yassin964770/iv-monitor/report-figures/fig1-board.html

Load cell, 3 kgخلية الحمل، 3 كغم

Wooden arm holding the load cellذراع خشبي يحمل خلية الحمل

IV bottle, hung from the load cellقنينة المحلول، معلّقة بخلية الحمل

Drip chamberحجرة التنقيط

IV tubeأنبوب المحلول

To the patientإلى المريض

USB cable to the ESP32كيبل USB للـESP32

OLED screen, 0.96 inشاشة OLED بقياس 0.96 إنش

ESP32 microcontrollerالمتحكم ESP32

HX711 amplifierمضخّم الإشارة HX711

Breadboardلوحة التوصيل

Red and green lights, 220 Ω eachضوء أحمر وأخضر، مقاومة 220 أوم لكل واحد

Buzzerالجرس

Servo lead and power wires, tapedسلك السيرفو وسلك التغذية، مثبّتان بشريط

Pinch point: the horn presses the tubeنقطة الضغط: ذراع السيرفو يعصر الأنبوب

Servo motor, the valveمحرك سيرفو يعمل كصمام

Wooden block behind the tubeقطعة خشب خلف الأنبوب

Cut USB cable: 5 V and GND for the servoكيبل USB مقصوص: 5 فولت والأرضي للسيرفو

Power bank, or a USB charger with two portsباور بانك، أو شاحن USB بمنفذين
