yassin964770/iv-monitor/report-figures/fig3-lights-buzzer.html

ESP32 microcontrollerالمتحكم ESP32

Green: plenty leftأخضر: الكمية كافية

Red: nearly emptyأحمر: قرب ينتهي

Active buzzer, 2 legsجرس نشط بطرفين

Each LED: pin, then a 220 Ω resistor, then the long leg (+); the short leg (−) to ground.كل ليد: المنفذ، بعدين مقاومة 220 أوم، بعدين رجله الطويلة (+)، ورجله القصيرة (−) للأرضي.

Buzzer: long leg (+) to GPIO 25, short leg (−) to ground, no resistor (an active buzzer).الجرس: رجله الطويلة (+) على GPIO 25، والقصيرة (−) للأرضي، بدون مقاومة (جرس نشط).

All grounds are joined with the ESP32 ground.كل الأرضيات موصولة بأرضي ESP32.
