yassin964770/iv-monitor/print-parts/cam-valve-drawings.pdf

منظر من األعلى

منظر من األسفل، جهة السريفو

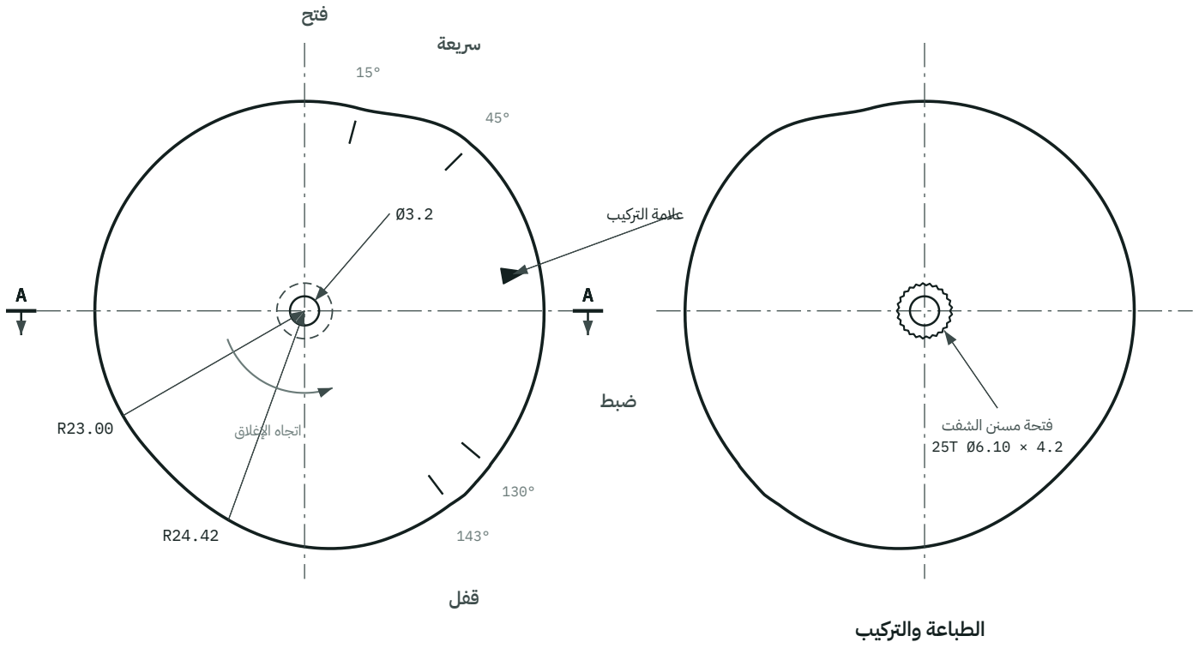
[picture p1: figure]
فتح; رسيعة; ضبط; قفل; عالمة الرتكيب; اتجاه اإلغالق; فتحة مسنن الشفت 25T Ø6.10 × 4.2; الطباعة والرتكيب

## A-A المقطع

7
4.2

Ø6.10

Ø3.2

49.27

نقاط الحافة
u° السريفو° R الفتحة الجريان% المنطقة 0 10 23.00 4.60 100 فتح
15 25 23.00 4.60 100 رسيعة 25 35 23.73 3.87 100 رسيعة 35 45 25.09 2.51 99 رسيعة
45 55 25.82 1.78 95 ضبط
55 65 26.06 1.54 84 ضبط
65 75 26.15 1.45 73 ضبط
75 85 26.21 1.39 61 ضبط
85 95 26.25 1.35 50 ضبط
95 105 26.28 1.32 39 ضبط
105 115 26.32 1.28 28 ضبط
115 125 26.35 1.25 17 ضبط
125 135 26.40 1.20 6 ضبط
130 140 26.50 1.10 0 قفل
135 145 26.60 1.00 0 قفل
139 149 26.75 0.85 0 قفل
143 153 26.60 1.00 0 قفل
150 160 26.60 1.00 0 قفل
160 26.60 1.00 0 رجوع
200 24.42 3.18 رجوع
230 23.00 4.60 فتح
230-
360

23.00 4.60 فتح

R من محور الشفت. الفتحة بني الحافة ووجه الجرس عند هذه الزاوية. الجريان تقدير محسوب. كل درجة بالملف .cam-profile.csv

.1 اطبعها والوجه العلوي على الرسير، ففتحة المسنن

تطلع لفوق بدون دعامات.

.2 ترنكب على مسنن الشفت مبارشة بدل الريشتني،

وبرغي الريشتني يشدها من فوق.

.3 بها بحيث عالمة الرتكيب أقرب ما يكون
ّك

على 90° ر
للجرس. الفتح ،20° الضبط 55° إىل ،140° السد .160°
.4 العالمات محفورة 0.4 ملم على الوجه العلوي.

القطعة :1 الكامة، بدل الريشتني

المرشوع

صمام الكامة لجهاز مراقبة المغذي

اللوحة
1 / 2
المادة

### PETG، حشوة %100

المقياس
1 : ،1.5 األبعاد بالملم

الحالة

### أبعاد السريفو من مخطط TowerPro لهيكل 945MG. تتأكد بالقياس: طول مسنن الشفت وقطر األنبوب

منظر من األعلى

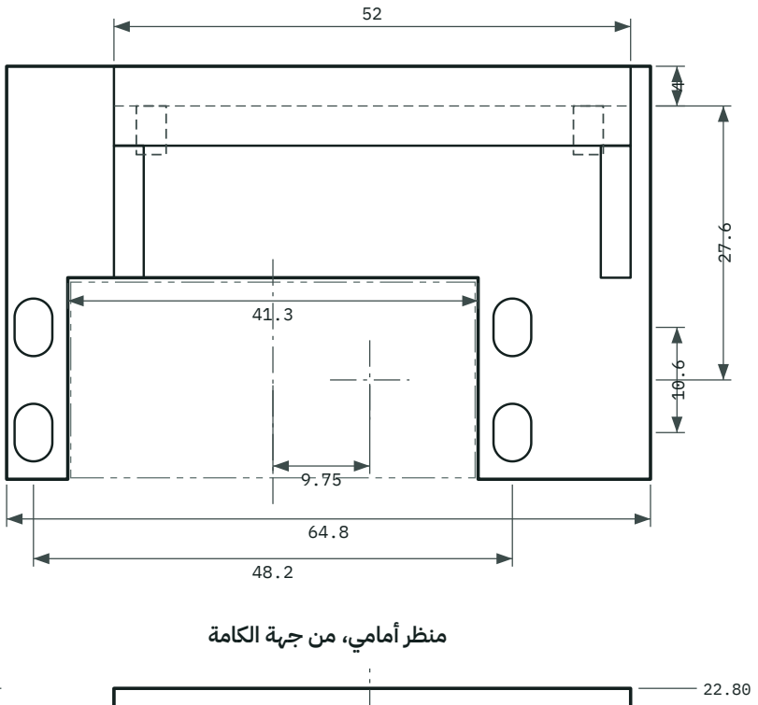
[picture p2: figure]
منظر أمامي، من جهة الكامة

## المقطع B-B عند محور الشفت

الطباعة والرتكيب

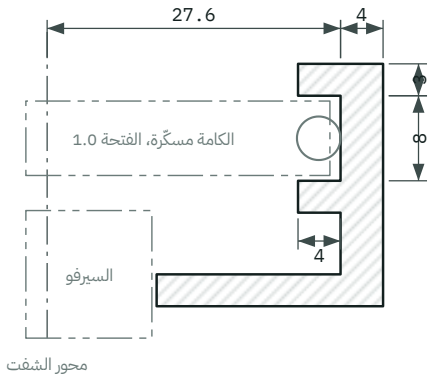
[picture p3: figure]
محور الشفت; رة، الفتحة 1.0; الكامة مس ّك; السريفو

.1 اطبعه وظهر الجدار على الرسير: الحافتني والضلعني والمشابك والقاعدة كلها تطلع لفوق،
بدون دعامات.

### .2 القاعدة تنحط على أذنني السريفو، واألذنني على تبوييب حامل السريفو من اردونك )-ARD 080016(. أربع براغي 12 × 3M مع صواميل تمر بالجرس واألذنني والحامل. والحامل يرنبط

على اللوح من صفيحته الطويلة، فالشفت يطلع لربة من اللوح.

.3 الفتحات الطويلة تسمح بتحريك الجرس 1 ملم نحو الكامة أو بعيد عنها: اضبطه على السد
الكامل وشد الرباغي.
.4 األنبوب ينكبس بني أصابع المشبكني )الفتحة ،4.2 اإلصبع 4.9 × 1.5 × 3(، ويمر

بالمجرى بني الحافتني.
.5 الفتحات الطويلة 5.8 × .3.8 الضلعني سمكهن 3 وارتفاعهن 5.8 فوق القاعدة.

.6 الخطوط المتقطعة الرفيعة للسريفو والكامة واألنبوب، للتوضيح، ومو جزء من القطعة.

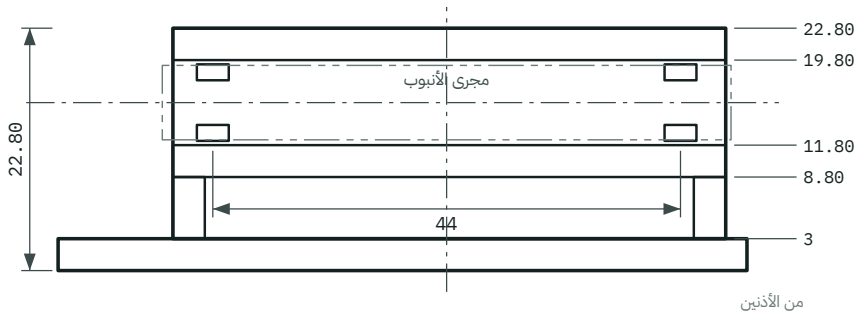
[picture p4: figure]
من األذنني; مجرى األنبوب

القطعة :2 الجرس الثابت

المرشوع

صمام الكامة لجهاز مراقبة المغذي

اللوحة
2 / 2
المادة

### PETG، حشوة %100

المقياس
1 : ،1.5 األبعاد بالملم

الحالة

### أبعاد السريفو من مخطط TowerPro لهيكل 945MG. تتأكد بالقياس: طول مسنن الشفت وقطر األنبوب
