yassin964770/iv-monitor/print-parts/sheet1.png

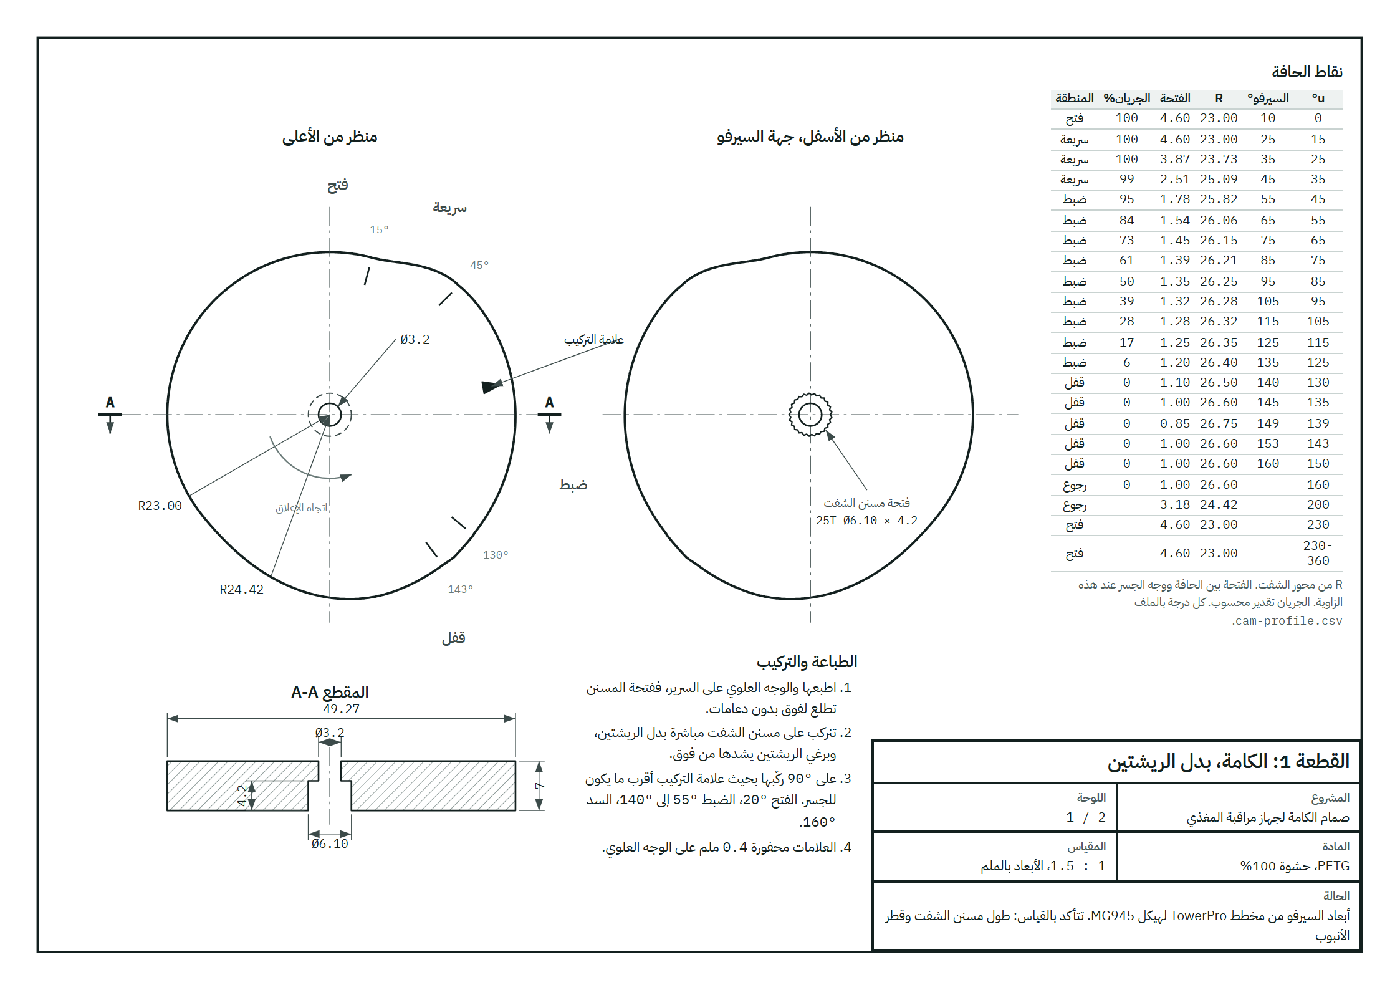
print-parts/sheet1.png
