yassin964770/iv-monitor/print-parts/sheet2.png

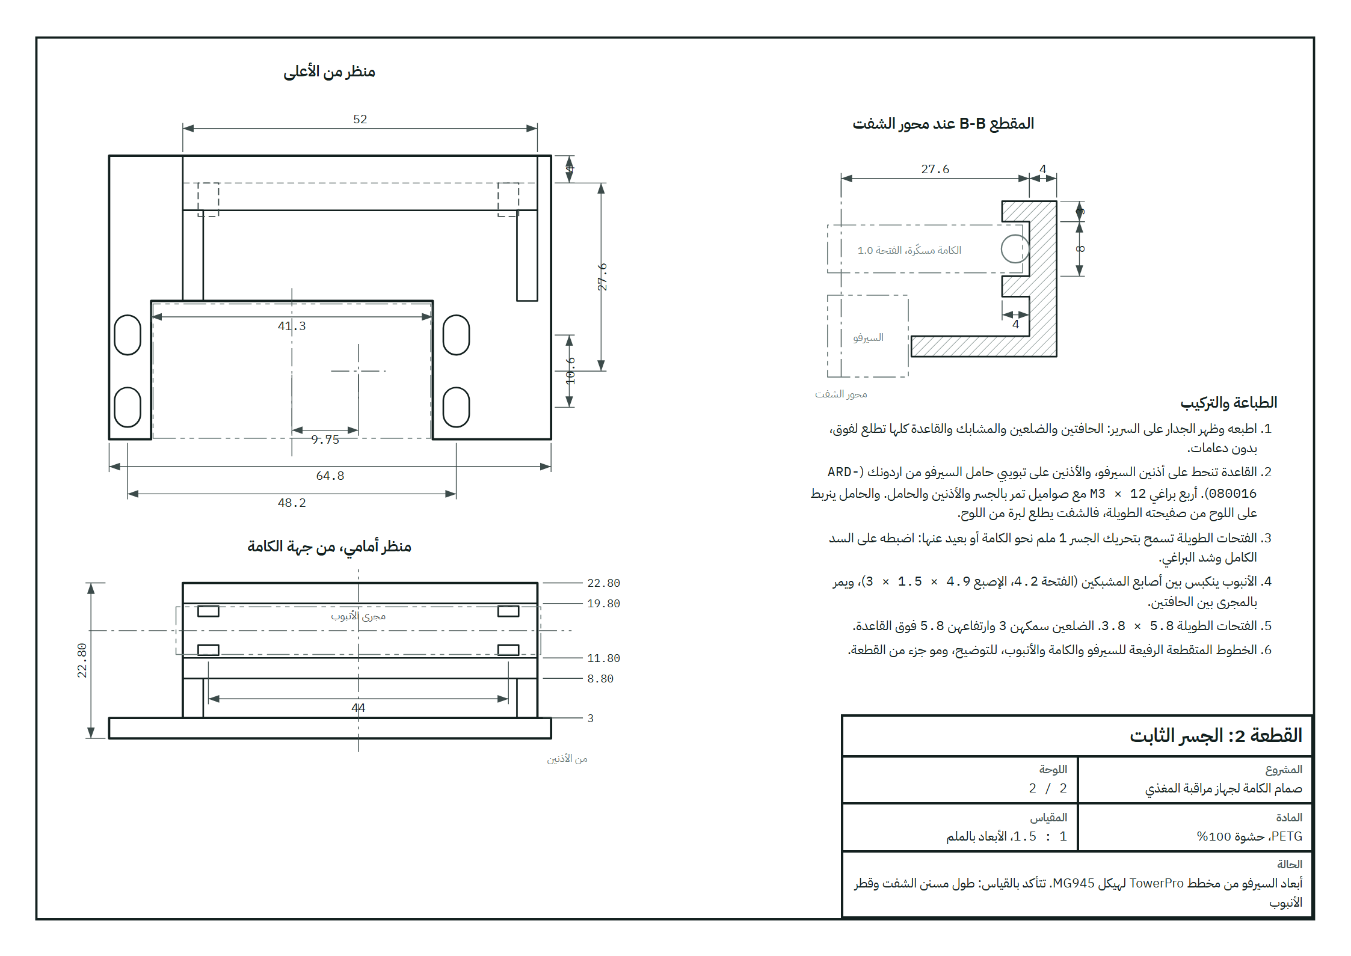
print-parts/sheet2.png
