yassin964770/iv-monitor/print-parts/cam.stl

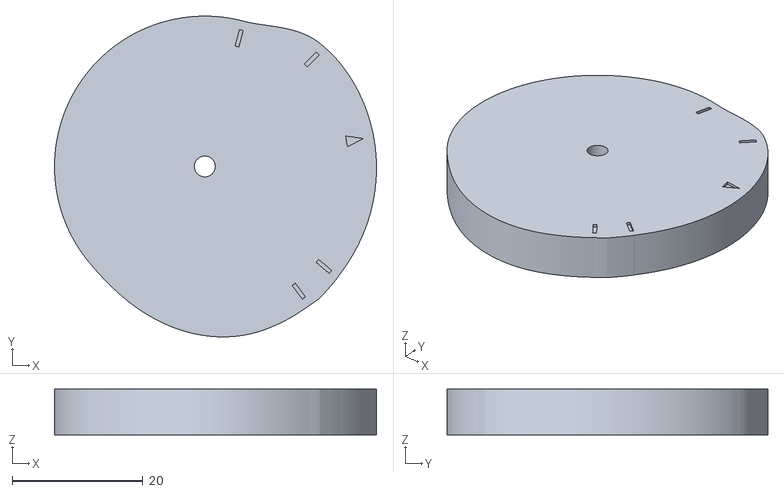
[picture p7: CAD file, 2026-11-10]
print-parts/cam.stl
49.3 x 49.1 x 7.00
