yassin964770/iv-monitor/print-parts/bridge.stl

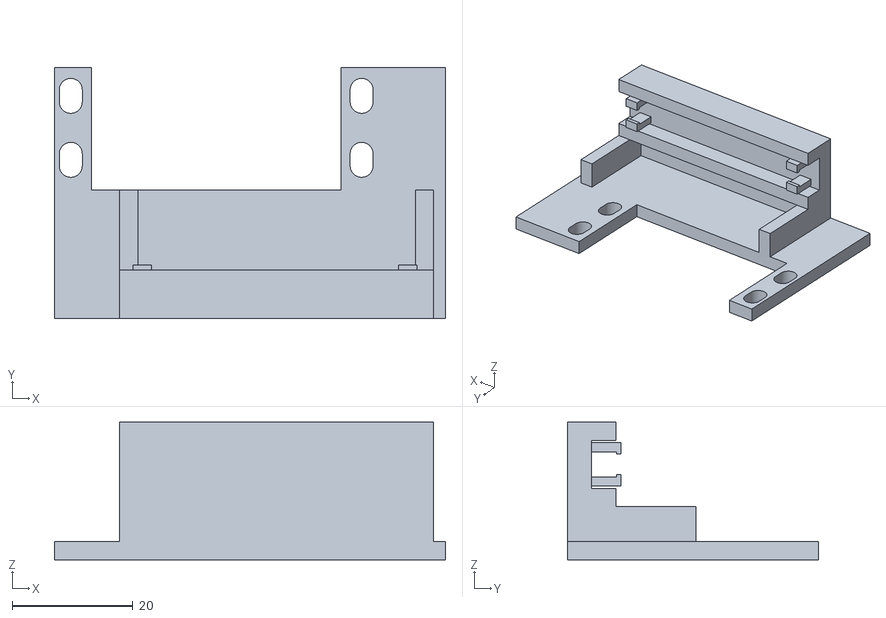
[picture p8: CAD file, 2026-11-10]
print-parts/bridge.stl
64.8 x 41.6 x 22.8
