yassin964770/iv-monitor/report-figures/fig2-wiring.html

Load cell, 3 kgخلية الحمل، 3 كغم

HX711 amplifierمضخّم الإشارة HX711

ESP32 microcontrollerالمتحكم ESP32

Green lightضوء أخضر

Red lightضوء أحمر

Buzzerالجرس

OLED screen, 0.96 inشاشة OLED بقياس 0.96 إنش

Servo motor, the valveمحرك سيرفو يعمل كصمام

Power bank or 2-port USB chargerباور بانك أو شاحن USB بمنفذين

Cut USB cableكيبل USB مقصوص

The servo takes 5 V straight from the second USB cable, not from the ESP32.السيرفو يأخذ 5 فولت مباشرة من كيبل USB الثاني، وليس من متحكم ESP32.

All grounds are joined: ESP32, HX711, screen, lights, buzzer, servo and the cut cable.كل الأرضيات موصولة ببعض: ESP32 وHX711 والشاشة والمصباحان والجرس والسيرفو والكيبل المقصوص.
