yassin964770/iv-monitor/SETUP-MQTT.md

# تشغيل المراقب على الإنترنت

الجهاز يرسل القراءات إلى خادم MQTT على الإنترنت، ولوحة التحكم (`dashboard/index.html`) تقرأ منه وترسل أوامر الفتح والإغلاق. الخادم مضبوط مسبقاً في الكود، فالمستخدم يختار شبكة البيت فقط.

## 1. أول تشغيل: شبكة البيت فقط

1. شغّل الـESP32. إذا لم يجد شبكة محفوظة، يفتح صفحة الإعداد على شبكته **IV-Monitor** وكلمة سرها **12345678**.
2. ادخل عليها من الموبايل. تفتح صفحة الإعداد وحدها، وإذا لم تفتح افتح `http://192.168.4.1`.
3. اضغط **Configure WiFi**، واختر شبكة البيت، واكتب كلمة سرها، ثم **Save**.

يتصل الجهاز بالبيت وبالخادم. إذا لم يُدخل شيء خلال 3 دقائق، يكمل عمله ويظل يبحث عن الشبكة المحفوظة في الخلفية.

شبكة **IV-Monitor** تبقى تعمل دائماً، حتى وهو متصل بالراوتر، والصفحة المحلية عليها `http://192.168.4.1`.

**تغيير الشبكة لاحقاً:** من الصفحة المحلية، تحت **الإعدادات والمعايرة**، زر **ربط الجهاز بشبكة واي فاي أخرى**. أو اكتب `wifi` في الـSerial Monitor، أو اضغط زر التصفير وأنت تشغّل الجهاز.

## 2. الصفحة المحلية داخل البيت

على نفس شبكة البيت افتح `http://iv-monitor.local`، أو العنوان الذي يظهر بالأمر `net` في الـSerial Monitor. بعض أجهزة أندرويد لا تفهم `.local`، فاستخدم العنوان بالأرقام.

تحت **الإعدادات والمعايرة** تجد اسم الشبكة المتصل بها، وهل اللوحة على الإنترنت متصلة.

## 3. لوحة التحكم من أي مكان

افتح رابط اللوحة على GitHub Pages من أي متصفح فيه إنترنت. تتصل بالجهاز مباشرة، دون تسجيل دخول.

اسم الجهاز ورمز التحكم مكتوبان في أول الكود داخل `dashboard/index.html` (`DEVICE`). لجهاز آخر غيّرهما هناك.

## الإعدادات المتقدمة (للمطوّر فقط)

القيم الافتراضية في أول الكود (`iv_monitor.ino`):

| الثابت | القيمة | المعنى |
|---|---|---|
| `DEFAULT_MQTT_HOST` | `broker.hivemq.com` | خادم MQTT عام، لا يحتاج حساب |
| `DEFAULT_MQTT_PORT` | `8883` | اتصال مشفّر. إذا فشل مرتين، يجرب `1883` (غير مشفّر، والأوامر تبقى موقّعة) ثم يرجع إليه بالتناوب |
| `DEFAULT_CONTROL_KEY` | `Wq7rT2kZ9pLm4xVb` | رمز التحكم: كل أمر يُوقَّع به |

اسم الجهاز يتولد تلقائياً من رقم الشريحة، مثل `iv-c83d26`.

لتغييرها بدون إعادة رفع الكود: في صفحة الإعداد اضغط **Setup**، وغيّر الخادم أو المستخدم أو كلمة المرور أو اسم الجهاز أو رمز التحكم. وغيّر نفس القيم في `DEVICE` داخل `dashboard/index.html`.

### خادم خاص بدل العام

للعمل الجدي يُفضّل حساب مجاني على **HiveMQ Cloud**: أنشئ Cluster ومستخدمَين (للجهاز وللوحة) بصلاحية Publish and Subscribe، ثم أدخل العنوان وبيانات مستخدم الجهاز في **Setup**، وبيانات مستخدم اللوحة في `DEVICE` داخل `dashboard/index.html` (الحقلان `user` و`pass`).

## المواضيع (Topics)

| الموضوع | الاتجاه | المحتوى |
|---|---|---|
| `ivmon/<device>/state` | من الجهاز | القراءات كاملة بصيغة JSON، كل ثانيتين |
| `ivmon/<device>/status` | من الجهاز | `online` أو `offline` (يرسله الخادم وحده إذا انقطع الجهاز) |
| `ivmon/<device>/cmd` | إلى الجهاز | `<الوقت بالملي ثانية>|<الأمر>|<HMAC-SHA256>` |
| `ivmon/<device>/ack` | من الجهاز | `ok ...` أو `error ...` لكل أمر |

الأوامر: `open`، `close`، `tare`، `cal 500`، `servo 90`، `set emptyG=38&lowMl=50`.

## الأمان

- **الخادم العام يقرأه أي شخص:** القراءات مكشوفة لمن يعرف اسم الجهاز. لهذا لا يُستخدم مع بيانات مرضى حقيقية.
- **الأوامر موقّعة:** الجهاز يرفض أي أمر بدون رمز التحكم الصحيح، ويرفض الأمر القديم المعاد إرساله. جُرّب: أمر برمز خاطئ رُفض.
- **رمز التحكم مكتوب في اللوحة المنشورة:** من يفتح الرابط يستطيع الفتح والإغلاق، ومن يقرأ الكود يعرف الرمز. يكفي لعرض المشروع، ولا يكفي لنظام حقيقي.
- **الجهاز لا يتحقق من شهادة الخادم** (`setInsecure`). يكفي للتجربة، وفي نظام حقيقي تُضاف الشهادة.
- كلمة سر شبكة الإعداد `12345678` للتجربة فقط، وتتغير من `AP_PASS` في الكود.
- التجربة بالماء فقط، ولا يُربط الجهاز على مريض.
