yassin964770/iv-monitor/user-guide/img/online-full.png

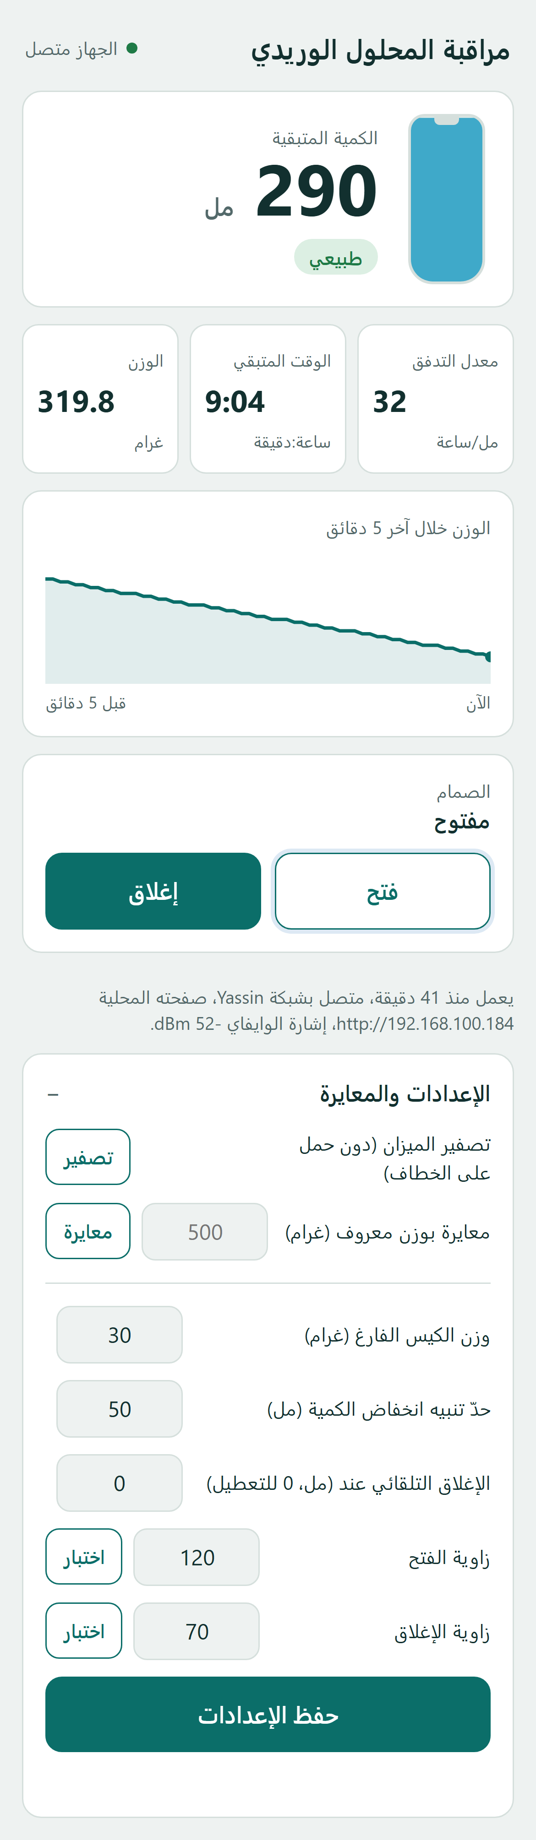
user-guide/img/online-full.png
