yassin964770/iv-monitor/wiring-diagram.png

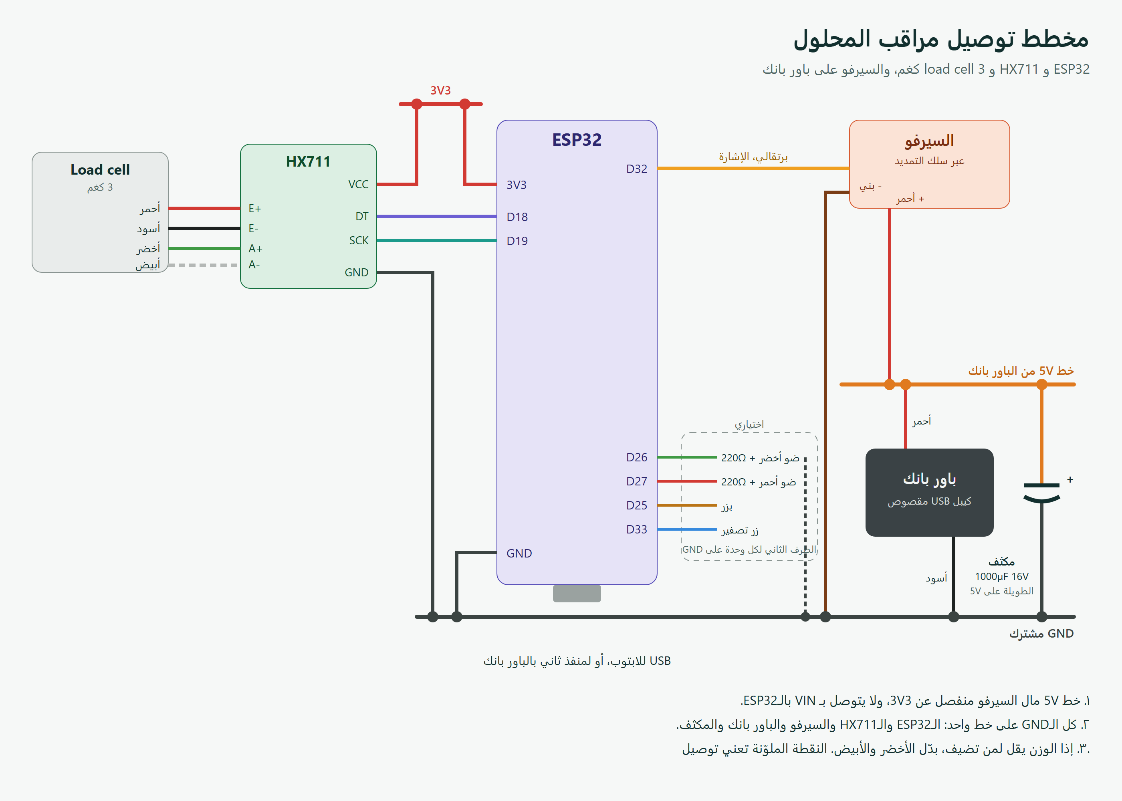
wiring-diagram.png
