yassin964770/iv-monitor/(commit log)

2026-11-05 IV monitor: ESP32 firmware, OLED screen, MQTT dashboard for GitHub Pages
2026-11-06 Keep the device's own Wi-Fi always on, bring MQTT back with a port fallback
    - IV-Monitor network stays up next to the router (AP+STA), so the page at
    192.168.4.1 works with any router or none; setup uses the same name.
    - Keeps looking for the saved router in the background; the local page can
    restart into Wi-Fi setup.
    - MQTT on again for the GitHub Pages dashboard; falls back to 1883 when 8883
    is blocked, with a growing wait between attempts.
    - Servo driven by LEDC: pushes 0.6 s then lets go, no twitch on re-attach.
    - Valve state saved and correctable from the page; alerts off by default.
    - Screen shows the router address and the device's own Wi-Fi in turn.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
    [iv_monitor.ino, screen.ino]
2026-11-06 Survive the Wi-Fi start on a weak USB port
    The radio's start-up burst browned out the chip on laptop USB and it restarted
    in a loop. The brownout guard is now off only while the network starts.
    [iv_monitor.ino]
2026-11-10 Screen text fix, LED and buzzer docs, report figures, guides and the cam valve parts
    - screen.ino: the address screen's second line fits the 64 px width ("in browser", the network name alone)
    - iv_monitor.ino: header comment describes the network as it works now (comment only)
    - report-figures: the board as built, the wiring, and the green/red LEDs and buzzer on GPIO 26/27/25
    - technical-guide, user-guide, package: Arabic guides, now covering the two LEDs and the buzzer
    - print-parts and servo-cam-valve-3d.html: the printed cam valve (drawings, STL files, 3D views)
    [bridge.stl, cam-profile.csv, cam.stl]
2026-11-10 Board and wiring drawings show the lights and buzzer on their pins
    - fig1: green and red lights (220 ohm each) and the buzzer on the breadboard beside GPIO 26, 27 and 25; the
    ESP32's wires now land on the rows of its real 30-pin layout, and its ground goes to the ground rail
    - fig2: the two lights and the buzzer on the wiring diagram, their grounds joined with the rest
    - guides and the package description rebuilt with the new drawings
    [make_fig1.py, make_fig2.py]
2026-11-10 Technical guide now ends with the attached files and builds the code zip
    The technical guide ends with the attached files (each file, the main constants, how to build, upload and publish)
    and builds iv-monitor-code.zip from the current code, the drawings and the guide itself.
2026-11-11 Dashboard: switch the alerts (buzzer, red light, screen) on and off from anywhere
    The device already takes 'set alerts=0/1' as a signed MQTT command; the dashboard had no switch for it.
